abersailbot/Captain-H-Morgan/Resource/abersailbot-logo-white-blue.dxf

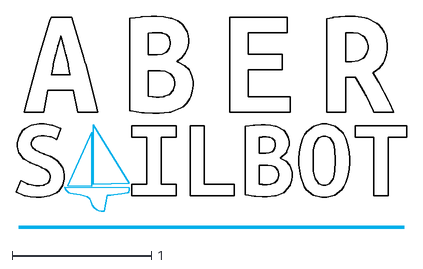
[picture p1: CAD file, 2020-03-05]
Resource/abersailbot-logo-white-blue.dxf
2.80 x 1.53
