abersailbot/Captain-H-Morgan/captain-h-morgan.kicad_pcb

## KiCad design captain-h-morgan.kicad_pcb (2020-03-05)

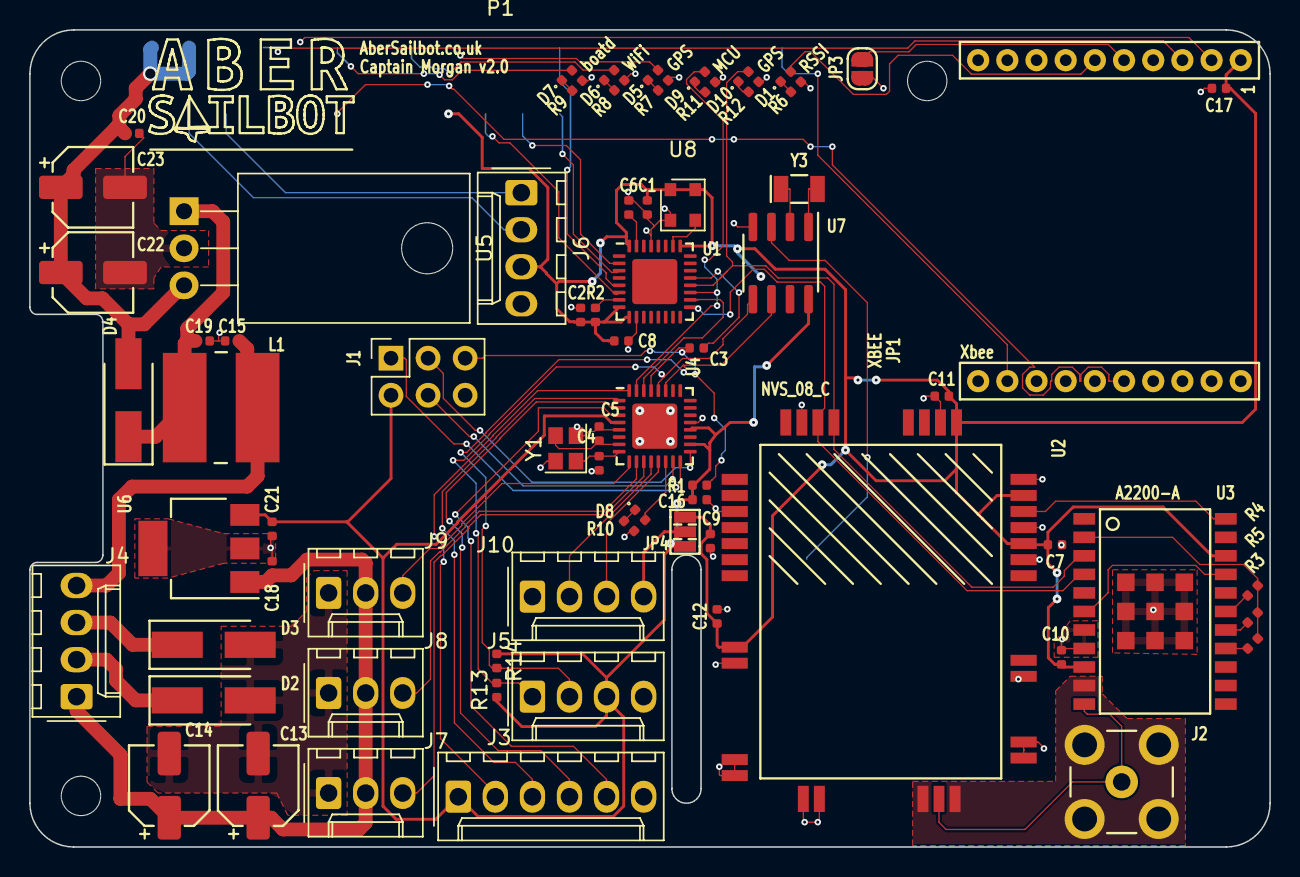
[picture p2: board captain-h-morgan.kicad_pcb from above]

Board: 2 copper layers, 85.0 x 56.0 mm, 76 parts (1 on the bottom side), 69 nets.

Parts:
BT1: Battery_Cell; BatteryHolder_Keystone_3000_1x12mm
C1: 0.1uF; C_0402_1005Metric
C2, C7, C8, C10, C11, C12, C18, C20: 0.1uf; C_0402_1005Metric
C3: 100nf; C_0402_1005Metric
C4, C5: 22pf; C_0402_1005Metric
C6: 1uf; C_0402_1005Metric
C9: .1uf; C_0402_1005Metric
C13, C14, C22, C23: 47uf; CP_Elec_5x5.8
C15, C21: 10uf; C_0402_1005Metric
C16, C17: 3.3uf; C_0402_1005Metric
C19: 4.7uf; C_0402_1005Metric
D1, D5, D6, D7, D8, D9, D10: LED; LED_0402_1005Metric
D2, D3, D4: 40TE25; D_SMA_Handsoldering
J1: Conn_02x03_Odd_Even; PinSocket_2x03_P2.54mm_Vertical
J2: Conn_Coaxial_Power; SMB_Jack_Vertical
J3: Conn_01x06_Male; Molex_KK-254_AE-6410-06A_1x06_P2.54mm_Vertical
J4: Conn_01x04; Molex_KK-254_AE-6410-04A_1x04_P2.54mm_Vertical
J5, J6, J10: Conn_01x04_Male; Molex_KK-254_AE-6410-04A_1x04_P2.54mm_Vertical
J7, J8, J9: Conn_01x03_Male; Molex_KK-254_AE-6410-03A_1x03_P2.54mm_Vertical
JP1: XBEE
JP3: Jumper_2_Open; SolderJumper-2_P1.3mm_Open_RoundedPad1.0x1.5mm
JP4: Jumper_NC_Dual; 3p_Jumper
L1: 10uH; L_Wuerth_WE-PD2-Typ-L
MK1, MK2, MK3: M2.5; MountingHole_2.7mm_M2.5
P1: Conn_02x20_Odd_Even; Pi40SMD_REV
R1, R2, R4, R13, R14: 10k; R_0402_1005Metric
R3, R5: 2.2k; R_0402_1005Metric
R6, R7, R8, R9, R10, R11, R12: 33; R_0402_1005Metric
U1: MAX3109; QFN-32-1EP_5x5mm_P0.5mm_EP3.1x3.1mm
U2: NV08C-CSM; NV08C
U3: A2200-A; XCVR_A2200-A
U4: ATmega328PB-MU; QFN-32-1EP_5x5mm_P0.5mm_EP3.1x3.1mm
U5: R-78B-2.0; TO-220-3_Horizontal_TabDown
U6: LM2937xMP; SOT-223-3_TabPin2
U7: DS1307+; SOIC-8_3.9x4.9mm_P1.27mm
U8: DSC61XX; DSC61xx-CDFN4
Y1: 16Mhz; Crystal_SMD_2520-4Pin_2.5x2.0mm
Y3: 32.768khz; Crystal_SMD_MicroCrystal_CC7V-T1A-2Pin_3.2x1.5mm

Connections:
+3V3: C1.2, C2.2, C7.2, C8.2, C9.1, C10.2, C11.2, C12.1, C17.1, J6.3, JP1.1, JP4.1, P1.1, P1.17, R2.2, U1.8, U1.9, U1.25, U1.32, U2.8, U2.23, U2.26, U2.28, U3.9, U3.20, U8.1, U8.4
+5V: C20.1, C22.1, C23.1, D4.2, P1.2, P1.4, U5.3
/1v8: R3.2, R4.2, R5.2, U3.2
/Arduino: D8.2, U4.14
/Arduino_SCL: J5.2, R14.2, U4.27, U7.6
/Arduino_SDA: J5.1, R13.2, U4.28, U7.5
/Boat_D: D7.2, P1.12
/GPIO2(SDA1): J6.2, P1.3
/GPIO3(SCL1): J6.1, P1.5
/GPIO8(SPI0_CE_N): P1.24, U1.5
/GPIO9(SPI0_MISO): P1.21, U1.2
/GPIO10(SPI0_MOSI): P1.19, U1.6
/GPIO11(SPI0_SCK): P1.23, U1.3
/GPIO14(TXD0): JP1.3, P1.8
/GPIO15(RXD0): JP1.2, P1.10
/GPIO16: JP1.12, P1.36
/GPIO17(GEN0): JP1.16, P1.11
/GPIO23(GEN4): D6.2, P1.16
/GPIO24(GEN5): D5.2, P1.18
/GPS_ANT: J2.1, U2.15, U3.11
/GPS_ANT_GND: J2.2, U2.14, U2.16, U3.10
/GPS_RST: U2.25, U3.22
/GPS_RX: U1.17, U2.33, U3.4
/GPS_TX: D10.2, U1.20, U2.32, U3.3
/IRQ: R2.1, U1.7
/RC_IN_A: J3.2, U4.32
/RC_IN_B: J3.3, U4.1
/RC_IN_C: J3.4, U4.2
/RC_IN_D: J3.5, U4.3
/RC_V: C16.1, C21.1, J1.2, J3.1, J5.3, JP4.3, R1.2, R13.1, R14.1, U4.4, U4.18, U4.20, U6.3, U7.8
/SLF_ST: U3.6, U3.19
/Servo0: J7.3, U4.11
/Servo1: J8.3, U4.10
/Servo2: J9.3, U4.9
/Vcomp: C15.1, J4.4, L1.1
/Wind_Rx: J10.3, U4.13
/Wind_Tx-PluseIn: J10.2, U4.12
/arduino_rts: C3.1, U1.21
/arduino_rx: U1.18, U4.30
/arduino_tx: D9.2, U1.19, U4.31
/iscp_miso: J1.1, U4.16
/iscp_mosi: J1.4, U4.15
/iscp_rst: C3.2, J1.5, R1.1, U4.29
/iscp_sck: J1.3, U4.17
GND: BT1.2, C1.1, C2.1, C4.1, C5.1, C6.1, C7.1, C8.1, C9.2, C10.1, C11.1, C12.2, C13.2, C14.2, C15.2, C16.2, C17.2, C18.2, C19.2, C20.2, C21.2, C22.2, C23.2, D2.2, D3.2, J1.6, J3.6, J5.4, J6.4, J7.1, J8.1, J9.1, J10.1, JP1.10, JP3.1, P1.6, P1.9, P1.14, P1.20, P1.25, P1.30, P1.34, P1.39, R6.2, R7.2, R8.2, R9.2, R10.2, R11.2, R12.2, U1.10, U1.29, U2.3, U2.9, U2.10, U2.11, U2.12, U2.13, U2.17, U2.18, U2.19, U2.22, U2.24, U2.27, U2.29, U2.34, U3.7, U3.8, U3.23, U3.24, U3.25, U3.26, U3.27, U3.28, U3.29, U3.30, U3.31, U4.5, U4.21, U4.33, U5.2, U6.2, U7.4, U8.2, Y1.2, Y1.4
unnamed: BT1.1, U7.3
unnamed: C4.2, U4.8, Y1.1
unnamed: C5.2, U4.7, Y1.3
unnamed: C6.2, U1.31
unnamed: C19.1, D4.1, L1.2, U5.1
unnamed: D1.1, R6.1
unnamed: D1.2, JP1.6
unnamed: D2.1, J4.2
unnamed: D3.1, J4.3
unnamed: D5.1, R7.1
unnamed: D6.1, R8.1
unnamed: D7.1, R9.1
unnamed: D8.1, R10.1
unnamed: D9.1, R11.1
unnamed: D10.1, R12.1
unnamed: J10.4, JP4.2
unnamed: JP1.5, JP3.2
unnamed: R3.1, U3.15
unnamed: R4.1, U3.17
unnamed: R5.1, U3.16
unnamed: U1.26, U8.3
unnamed: U7.1, Y3.2
unnamed: U7.2, Y3.1
Vdrive: C13.1, C14.1, C18.1, J4.1, J7.2, J8.2, J9.2, U6.1
