abersailbot/Captain-H-Morgan/(threads)

Thread 1 (2016-12-02):

PCB on Pi

naturesyouth, 2016-12-02:
_From @colinsauze on September 4, 2015 19:35_

Put the AtMega and power distribution, possibly regulator on PCB that fits ontop of Pi.

_Copied from original issue: abersailbot/dewi-hardware#21_

naturesyouth, 2016-12-02:
At least part of this is being integrated on the mounting solution for #45

naturesyouth, 2016-12-02:
See abersailbot/dewi-hardware/pull/49

naturesyouth, 2016-12-02:
Version 1 has already be deployed at sailbot, and version 1.2 will be fabbed over summer for WRSC

naturesyouth, 2016-12-02:
_From @Danyc0 on June 18, 2016 12:59_

This should be closed when the PCB has been tested and is 100% working in fabbed state, with no extra jumper wires, etc. Think "done done".

naturesyouth, 2017-06-15:
The 1.2.2 version of this board appears perfect, closing issue.

Closed 2017-06-15.

Thread 2 (2016-12-02):

change the diode footprint for the power diodes

naturesyouth, 2016-12-02:
_From @naturesyouth on September 19, 2016 16:16_

_Copied from original issue: abersailbot/dewi-hardware#62_

naturesyouth, 2016-12-02:
_From @TomGC96 on December 1, 2016 16:30_

What's the progress on this @naturesyouth?

naturesyouth, 2016-12-02:
so in the current footprints are correct for SOD-232 diodes, however it is a pain to hand solder so I should change the pad.

Thread 3 (2016-12-02):

Find an alternative switch mode regulator for Captain H Morgan

naturesyouth, 2016-12-02:
_From @Danyc0 on September 8, 2016 14:34_

The DC-DC converter on CHM overheats and starts cutting its output at 71 degrees C, causing brown-outs on the arduino (but not the pi, probably because it can deal with a lower voltage). It then cuts out completely at 85 degrees C IIRC. An alternative is to find a way to keep everything cooler, because the whole board stack gets very (very) hot.

_Copied from original issue: abersailbot/dewi-hardware#58_

naturesyouth, 2016-12-02:
which rev of the board is this fault on? also can we get a current reading on the batt supply with everything plugged in?

naturesyouth, 2016-12-02:
_From @Danyc0 on September 8, 2016 17:16_

V1.2, and no. I'm pretty sure we're going over the 1A limit, we should use this instead: R-78Bxx-1.5(L), it supports up to 1.5A

naturesyouth, 2016-12-02:
hmm, we should already be using the 1.5A dc-dc, and when we did out calculations we should have been well under an amp...

naturesyouth, 2016-12-02:
_From @TomGC96 on September 9, 2016 11:28_

@naturesyouth is correct, yes, we are using the 1.5A regulator.

naturesyouth, 2016-12-02:
_From @Danyc0 on September 13, 2016 16:8_

Ah ok, well we still need to either find a replacement, or find another way to keep the box cool, as it's very much overheating. There is currently a tiny python script I wrote sitting on the Pi called temp.py which will both log and output the Pi's chip temperature once every 5 seconds

naturesyouth, 2016-12-02:
_From @Danyc0 on September 13, 2016 16:10_

The Arduino also has a cut off at 85 degrees C so maybe we just need to find a way to keep the box cooler. Increasing the height of the standoffs might help

naturesyouth, 2016-12-02:
can we run a test for whats making the most heat, i recon the best way to do this is setup a second arduino with some temp sensors fixed to various parts of the electronics as well as inside and outside the box, and then running  untill the overheat happens,

naturesyouth, 2016-12-02:
_From @Danyc0 on November 21, 2016 20:24_

Might be a good idea, there's a temperature sensor built into the IC on the Pi, and I build a rubbish little script which logs its data, but it only exists on the Pi we took to WRSC

Thread 4 (2016-12-02):

Alternative methods of Arduino programing

naturesyouth, 2016-12-02:
_From @naturesyouth on February 14, 2016 14:54_

It would be nice if someone could look into the possibility of programming the Arduino without a usb connection, either over spi or serial, preferably with some hardware experimentation. This is in refrence to #45

_Copied from original issue: abersailbot/dewi-hardware#48_

naturesyouth, 2016-12-02:
_From @Danyc0 on February 14, 2016 15:0_

So this page explains how to program an arduino using another arduino:
https://www.arduino.cc/en/Tutorial/ArduinoISP
I reckon if you reimplemented the ArduinoISP example (found built into the IDE these days) for the Pi it might just be possible. However I think that would take too much time to be worth it just for the purpose of getting rid of a USB cable

naturesyouth, 2017-10-19:
Becuase we should barely ever have to reprogram the embedded controller the programming pins can just be broken out to a header and then we can just program it with an external programmer.

Danyc0, 2017-10-22:
Being able to reprogram the arduino from the Pi without having to open any boats or boxes was an explicit design goal. It's super useful, especially in Kitty where getting the boxes out isn't the easiest thing in the world. It's also super useful for remote testing, where the boat is connected to the internet and everything is reprogrammed remotely

Thread 5 (2016-12-02):

Secure dc-dc.

naturesyouth, 2016-12-02:
_From @naturesyouth on November 21, 2016 19:35_

the dc-dc converters need to be glued down to the pcb to prevent mechanical stress from shearing the leads. hot glue would be best so it can be removed later.

_Copied from original issue: abersailbot/dewi-hardware#65_

Thread 6 (2016-12-02):

Opto isolate servo data lines

naturesyouth, 2016-12-02:
_From @colinsauze on September 4, 2015 19:11_

_Copied from original issue: abersailbot/dewi-hardware#12_

Thread 7 (2017-06-16):

Test using the MAX14830 for serial multiplexing.

naturesyouth, 2017-06-16:
I would like like to try using the MAX14830 to add some extra UART ports to the Pi, there should be a linux driver.

Danyc0, 2017-06-16:
Am I correct in reading that this is an SPI/I2C to UART bridge?

naturesyouth, 2017-06-16:
yeah, spi to 4 uart

naturesyouth, 2017-06-16:
for a total of five uarts on the pi.

rpasc, 2017-06-29:
Hi

MAX14830 is an option.

For the SPI interface there exists a module in the mainstream kernel http://elixir.free-electrons.com/linux/v4.12-rc7/source/drivers/tty/serial/max310x.c

I have shared a version that works with the I2C interface:
https://groups.google.com/d/msg/acmesystems/xLCdHYX81HA/nFw6HgwUOQAJ

This requires working at the kernel level and device trees. You will have to compile the kernel.

Another option, which does not require kernel level knowledge, is to use a USB to UART HUBs based on for example FTDI  FT4232H http://www.ftdichip.com/Products/Modules/DevelopmentModules.htm#FT4232H_Mini

This latter is around €27.

The boards I have with 14830 were custom designed and required soldering in an SMD oven... will be more expensive for small batches. I did get an Evaluation Kit at first, over €100...

Danyc0, 2017-06-29:
Sadly we have no free USB ports. We had a USB hub in Kitty and used an FTDI, but it just took up loads of space, something Captain Morgan is pretty much designed to try and save

naturesyouth, 2017-06-29:
Yeah part of the whole long term goal is to remove the need for USB devices and it's not out of the realm of possibility to solder a qfn by hand with the right footprint. I would be interested in knowing what sort of baudrate speeds you were able to get reliably with the i2c bus.

rpasc, 2017-06-30:
ah! only now I noticed this is for a robotic sailboat. Marine engineer on this side.

I was interested in getting 8 UART for an automation project, did so by using two 14830 on I2C. However, the board I used was the ARIAG25 and the module was the one I shared for kernel level. I did not test in RPi. I did not require high rate, 9600 bps is what I've been using on all ports at once. The device works in I2C but has buffer and interrupt driven reading.

I think you could get away soldering with hot air. Do you use Eagle PCB design software? I have schematics of the working 8 port circuit and would reduce it to 4 and share if that could be of use.

naturesyouth, 2017-06-30:
We use the KiCAD EDA package because it is open source, but I would love to see your schematic for reference, I hadn't considered using the i2c bus as I assumed that it would be too slow, but if you got it running at 9600 then it might be an interesting solution.

rpasc, 2017-07-03:
Should be enough to evaluate if you want to go that way.
[I2CUART.zip](https://github.com/abersailbot/captain-h-morgan/files/1120240/I2CUART.zip)

sbharsha, 2017-07-12:
I am using raspberry pi. can you post the device tree for MAX14830 over SPI. I am struggling to get the MAX14830 get work.

rpasc, 2017-07-12:
Sorry but I haven't used SPI or RPi with the device.

If you have an oscilloscope I would recommend that you try to put hardware problems aside, otherwise, if you have not tried I2C, I would recommend some common ground with respect to what I have. This means I2C, which should be relatively simple in this case because SPI and I2C pins are shared on the device. Enable I2C on the RPi.

Then with everything connected I would use shell command $i2cdetect -y dev

dev depends on which I2C bus you are using (0 or 1).

Only once hardware problems are set aside and the device is detected (try also without device to make sure it is the device that is responding) then you could try the driver I modified and the part of device tree which respects to the device.
https://groups.google.com/d/msg/acmesystems/xLCdHYX81HA/nFw6HgwUOQAJ

For I2C device at 6C

	max14830: max14830@6c {
                	compatible = "maxim,max14830";
                	reg = <0x6C>; // Just address of UART0, others will be inferred
                	maxim,clock-type = "xtal";
                	maxim,clock-frequency = <3686400>;
               		interrupts-extended = <&pioC 1 2>; //IRQ_TYPE_EDGE_FALLING
               		maxim,minorstart = <209>; //209 name will be ttyMAX0
               	};

Droid-MAX, 2018-10-14:
@sbharsha me too!

jaredvis, 2021-08-04:
Can I ask if @Droid-MAX or @sbharsha managed to get the MAX14830 working via SPI, I would really appreciate any assistance on this one.

Thread 9 (2017-06-16):

Add Temp and humidity sensor to captain Morgan.

naturesyouth, 2017-06-16:
i would like to add some sensors to monitor the electronics temperature and humidity, the BME280  looks like a good choice.

Danyc0, 2017-06-16:
Could this be expandable to using the same type of sensor to measure water temperature? I'm not sure if it's still in the rules, but you used to get points for stuff like that at WRSC

naturesyouth, 2017-06-16:
It's gonna be i2c, same as the prospective current sensors.

Thread 12 (2017-10-19):

Add 12v Boot circuit.

naturesyouth, 2017-10-19:
I would like to add a 12v supply circuit for NMEA spec devices, specifically the RoWind wind sensor.
By using a boost converter we should be able to support for 12v devices with no change to our power setup.

Thread 15 (2017-10-19):

Update GPS to A5200-A

naturesyouth, 2017-10-19:
Update the Design to support the A5200-A GPS, this is a drop in replacement and should be an improvement over the current GPS

Danyc0, 2017-10-22:
What improvement does it give? and why is that needed?
