abersailbot/Captain-H-Morgan/(commit log)

2016-02-14 Rename Pi-Expansion -> pi-expansion
    Lower case names are nicer to deal with.
    [Pi-Expansion.kicad_pcb, Pi-Expansion.sch]
2016-02-15 added custom library for arduino board with only mounting holes, also added in the hole position for ardino, and refined pcb outline
    [Pi-Expansion.kicad_pcb]
2016-02-15 fixed board outline, moved gps
    [Pi-Expansion.kicad_pcb]
2016-02-16 did a full layout of the pcb, should be pretty much compleat, also fixed yet more issues librarys
    [Pi-Expansion.dsn, Pi-Expansion.kicad_pcb, Pi-Expansion.sch]
2016-02-16 add copper fill for ground plane, and second mill revisions for prototyping
    [Pi-Expansion.kicad_pcb]
2016-05-16 Updated 3v3 and Gnd tabs on pi header on schmatic
    [Pi-Expansion.sch]
2016-05-16 Adds reverse voltage protection for DC-DC converter allowing for safe operation of pi form UUSB connector
    [Pi-Expansion.sch]
2016-05-16 Updated layout around gps, reconfigured for autowakeup and NMEA at 4800.
    [Pi-Expansion.sch]
2016-05-16 minor tweaks, and rotated pi header, removed infill and traces
    [Pi-Expansion.kicad_pcb, Pi-Expansion.sch]
2016-05-19 Made minor tweaks to schematic layout, updated footprints and tweaked pcb layout
    [Pi-Expansion.kicad_pcb, Pi-Expansion.sch]
2016-05-19 First draft pcb layout, most tracks in place, footprints in near final positions
    [Pi-Expansion.kicad_pcb, Pi-Expansion.sch]
2016-05-19 Final Layout, Traces and footprints in place, added GPS_TX sensing circuit 3.3v powerled.
    [Pi-Expansion.kicad_pcb, Pi-Expansion.sch]
2016-05-20 updated power footprints, minor tweaks
    [Pi-Expansion.kicad_pcb]
2016-05-22 Silk screen update, nudged some footprints for better flow.
    [Pi-Expansion.kicad_pcb]
2016-05-22 Final Commit for V1.2 'Captain H.Morgan', all planes, solder masks, and components in final places.
    [Pi-Expansion.kicad_pcb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]
2016-05-22 Documentation update, added notes to schematic.
    [Pi-Expansion.sch]
2016-05-22 Documentation tweaks
    [Pi-Expansion.sch]
2016-05-22 Updated GPS ground Pads
    [Pi-Expansion.kicad_pcb]
2016-05-23 updateded fab files with ground plane fix
    [Pi-Expansion-B.Adhes.gbr, Pi-Expansion-B.CrtYd.gbr, Pi-Expansion-B.Cu.gbr, Pi-Expansion-B.Fab.gbr, Pi-Expansion-B.Mask.gbr, Pi-Expansion-B.Paste.gbr, Pi-Expansion-Cmts.User.gbr, Pi-Expansion-Dwgs.User.gbr]
2016-06-17 made minor mods to power supply including moving reverse protection diode from negitive side to positive side to reduce voltage drop.
    [Pi-Expansion.kicad_pcb, Pi-Expansion.sch]
2016-06-17 minor tweaks to in fill
    [Pi-Expansion.kicad_pcb]
2016-06-18 cleared out fabrication files as they should be generated fresh when needed, also simplified circuitry for the tx sense led
    [Pi-Expansion-B.Adhes.gbr, Pi-Expansion-B.CrtYd.gbr, Pi-Expansion-B.Cu.gbr, Pi-Expansion-B.Fab.gbr, Pi-Expansion-B.Mask.gbr, Pi-Expansion-B.Paste.gbr, Pi-Expansion-B.SilkS.gbr, Pi-Expansion-Cmts.User.gbr]
2016-06-18 Added current limiting resistor for GPS TX indicator, also fiddled with Copper fill
    [Pi-Expansion.kicad_pcb, _saved_Pi-Expansion.sch]
2016-06-18 updated led resistor placement so they no longer obstruct the legand on the silk screen
    [Pi-Expansion.kicad_pcb]
2016-06-30 Final version sent to fab, retraced GPS_TX to fix net issue between 2k2 resistor and pi header
    [Pi-Expansion.kicad_pcb, Pi-Expansion.sch, _saved_Pi-Expansion.sch]
2016-09-07 Added voltage select jumper to VANT.
    [Pi-Expansion.sch]
2016-10-16 Added voltage select for GPS Vant between 5v and 3v3.
    [Pi-Expansion.kicad_pcb, Pi-Expansion.sch]
2016-11-21 Updated silkscreen typo.
    [Pi-Expansion.kicad_pcb]
2016-11-21 Nudged silkscreen for @tomgc96
    [Pi-Expansion.kicad_pcb]
2016-11-21 moved url to silkscreen and updated it for .co.uk address
    [Pi-Expansion.kicad_pcb]
2016-11-21 Moved led vias and traces to clear around silkscreen.
    [Pi-Expansion.kicad_pcb]
2016-11-21 de-capitalised gpsd
    [Pi-Expansion.kicad_pcb]
2017-06-19 Further cleanup removing unneeded auto generated files.
    [Pi-Expansion.dsn]
2017-06-19 More file clean outs, and removed dependancy libarys in favour of switching to either kicad of project spesific ones.
2020-03-05 Replaces old captain morgan files with formally Captain Morgan Revengence.
    [Pi-Expansion.kicad_pcb, Pi-Expansion.sch, abersailbot-logo-white-blue.dxf, captain-h-morgan.kicad_pcb, captain-h-morgan.sch]
